blchinezu/bekant-mqtt32/images/hardware/requirements/100nf-ceramic-capacitor.jpg

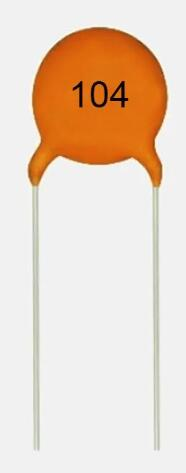
images/hardware/requirements/100nf-ceramic-capacitor.jpg
