blchinezu/bekant-mqtt32/images/hardware/requirements/box.jpg

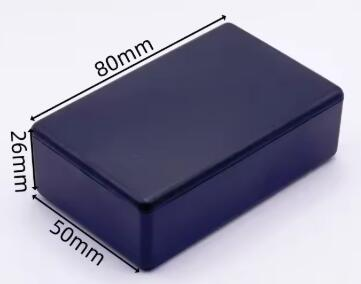
images/hardware/requirements/box.jpg
