blchinezu/bekant-mqtt32/images/hardware/requirements/buck-converter-5v.jpg

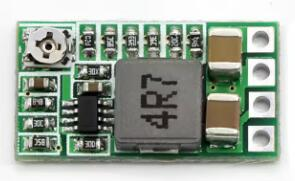
images/hardware/requirements/buck-converter-5v.jpg
