blchinezu/bekant-mqtt32/images/hardware/requirements/buck-converter-12v.jpg

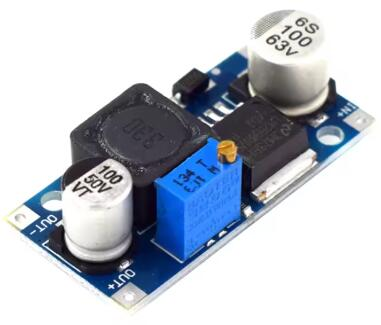
images/hardware/requirements/buck-converter-12v.jpg
