blchinezu/bekant-mqtt32/images/hardware/requirements/buttons.jpg

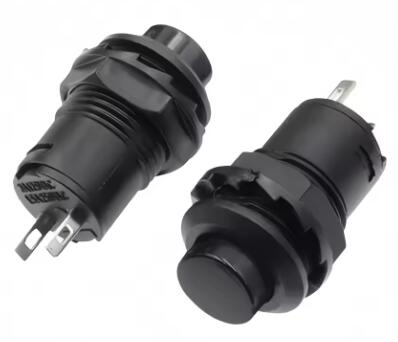
images/hardware/requirements/buttons.jpg
