blchinezu/bekant-mqtt32/images/hardware/requirements/esp32-d1-mini.jpg

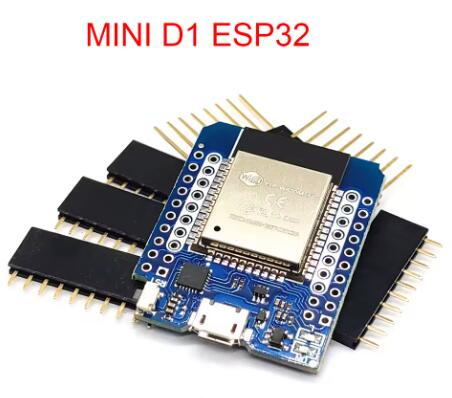
images/hardware/requirements/esp32-d1-mini.jpg
