blchinezu/bekant-mqtt32/images/hardware/requirements/mcp2003b.jpg

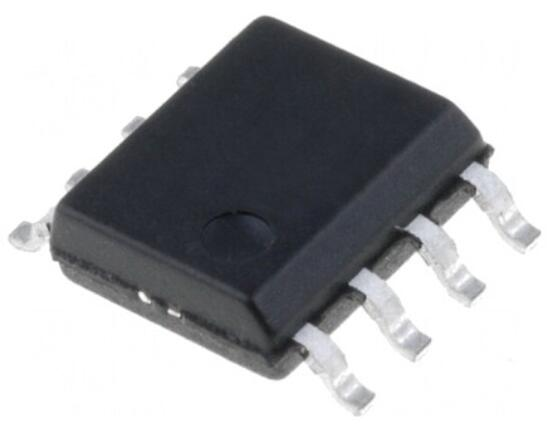
images/hardware/requirements/mcp2003b.jpg
