blchinezu/bekant-mqtt32/images/hardware/requirements/pcb.jpg

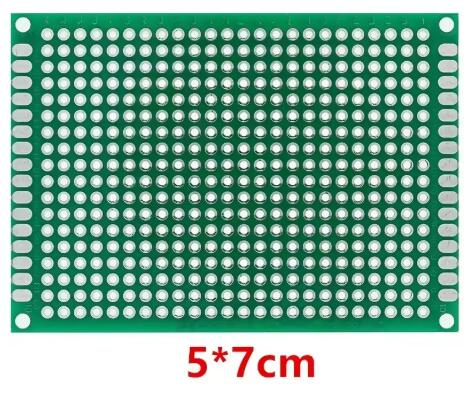
images/hardware/requirements/pcb.jpg
