blchinezu/bekant-mqtt32/images/hardware/requirements/sop8-to-dip8-pcb.jpg

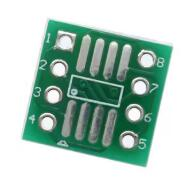
images/hardware/requirements/sop8-to-dip8-pcb.jpg
