blchinezu/bekant-mqtt32/lin.cpp

/*
 Copyright 2011 G. Andrew Stone
All rights reserved.

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
THIS SOFTWARE IS PROVIDED BY THE COPYRIGHT HOLDERS AND CONTRIBUTORS "AS IS" AND
ANY EXPRESS OR IMPLIED WARRANTIES, ZINCLUDING, BUT NOT LIMITED TO, THE IMPLIED
WARRANTIES OF MERCHANTABILITY AND FITNESS FOR A PARTICULAR PURPOSE ARE
DISCLAIMED. IN NO EVENT SHALL <COPYRIGHT HOLDER> BE LIABLE FOR ANY
DIRECT, INDIRECT, INCIDENTAL, SPECIAL, EXEMPLARY, OR CONSEQUENTIAL DAMAGES
(INCLUDING, BUT NOT LIMITED TO, PROCUREMENT OF SUBSTITUTE GOODS OR SERVICES;
LOSS OF USE, DATA, OR PROFITS; OR BUSINESS INTERRUPTION) HOWEVER CAUSED AND
ON ANY THEORY OF LIABILITY, WHETHER IN CONTRACT, STRICT LIABILITY, OR TORT
(INCLUDING NEGLIGENCE OR OTHERWISE) ARISING IN ANY WAY OUT OF THE USE OF THIS
SOFTWARE, EVEN IF ADVISED OF THE POSSIBILITY OF SUCH DAMAGE.
*/

#include "Arduino.h"
#include "lin.h"

Lin::Lin(LIN_SERIAL& ser,uint8_t TxPin,uint8_t RxPin)
  : serial(ser)
  , txPin(TxPin)
  , rxPin(RxPin)
{
}

void Lin::begin(int speed)
{
  serialSpd = speed;
  serial.begin(serialSpd, SERIAL_8N1, rxPin, txPin);
  serialOn  = 1;

  // More precise timing calculation like megadesk
  unsigned long int Tbit = 1000000UL/serialSpd;  // Convert to microseconds
  unsigned long int nominalFrameTime = (34+90)*Tbit;  // 34 bits header + 90 bits payload
  timeout = LIN_TIMEOUT_IN_FRAMES * nominalFrameTime;
}

// Generate a BREAK signal (a low signal for longer than a byte) across the serial line
void Lin::serialBreak(void)
{
  if (serialOn) {
    serial.flush();
    serial.end();
  }

  pinMode(txPin, OUTPUT);
  digitalWrite(txPin, LOW);  // Send BREAK
  const unsigned long int brkend = (1000000UL/((unsigned long int)serialSpd));
  const unsigned long int brkbegin = brkend*LIN_BREAK_DURATION;
  if (brkbegin > 16383) delay(brkbegin/1000);  // delayMicroseconds unreliable above 16383 see arduino man pages
  else delayMicroseconds(brkbegin);
  
  digitalWrite(txPin, HIGH);  // BREAK delimiter

  if (brkend > 16383) delay(brkend/1000);  // delayMicroseconds unreliable above 16383 see arduino man pages
  else delayMicroseconds(brkend);

  serial.begin(serialSpd, SERIAL_8N1, rxPin, txPin);
  serialOn = 1;
}

/* Lin defines its checksum as an inverted 8 bit sum with carry */
uint8_t Lin::dataChecksum(const uint8_t* message, char nBytes,uint16_t sum)
{
    while (nBytes-- > 0) sum += *(message++);
    // Add the carry
    while(sum>>8)  // In case adding the carry causes another carry
      sum = (sum&255)+(sum>>8); 
    return (~sum);
}

/* Create the Lin ID parity */
#define LIN_BIT(data,shift) ((addr&(1<<shift))>>shift)
uint8_t Lin::addrParity(uint8_t addr)
{
  uint8_t p0 = LIN_BIT(addr,0) ^ LIN_BIT(addr,1) ^ LIN_BIT(addr,2) ^ LIN_BIT(addr,4);
  uint8_t p1 = ~(LIN_BIT(addr,1) ^ LIN_BIT(addr,3) ^ LIN_BIT(addr,4) ^ LIN_BIT(addr,5));
  return (p0 | (p1<<1))<<6;
}

/* Send a message across the Lin bus */
void Lin::send(uint8_t addr, const uint8_t* message, uint8_t nBytes,uint8_t proto)
{
  uint8_t addrbyte = (addr&0x3f) | addrParity(addr);
  // LIN diagnostic (60) frame shall always use CHKSUM of protocol version 1.x (like megadesk)
  uint8_t cksum = dataChecksum(message,nBytes,(addr == 0x3c) ? 0: addrbyte);
  serialBreak();       // Generate the low signal that exceeds 1 char.
  serial.write(0x55);  // Sync byte
  serial.write(addrbyte);  // ID byte
  serial.write(message,nBytes);  // data bytes
  serial.write(cksum);  // checksum
  serial.flush();
}

uint8_t Lin::recv(uint8_t addr, uint8_t* message, uint8_t nBytes,uint8_t proto)
{
  uint8_t bytesRcvd=0;
  unsigned int timeoutCount=0;
  serialBreak();       // Generate the low signal that exceeds 1 char.
  serial.flush();
  
  // Debug: Check buffer state before starting
  int bufferBefore = serial.available();
  
  serial.write(0x55);  // Sync byte
  uint8_t idByte = (addr&0x3f) | addrParity(addr);
  serial.write(idByte);  // ID byte
  bytesRcvd = 0xfd;
  
  // Debug: Capture all bytes read for analysis
  uint8_t debugBytesRead[20];
  uint8_t debugByteCount = 0;
  int syncAttempts = 0;
  int idAttempts = 0;
  
  do { // I hear myself
    syncAttempts++;
    while(!serial.available()) { delayMicroseconds(100); timeoutCount+= 100; if (timeoutCount>=timeout) goto done; }
    uint8_t b = serial.read();
    if (debugByteCount < 20) debugBytesRead[debugByteCount++] = b;
    if (b == 0x55) break;
  } while(syncAttempts < 20);
  
  if (syncAttempts >= 20) goto done;
  
  bytesRcvd = 0xfe;
  do {
    idAttempts++;
    while(!serial.available()) { delayMicroseconds(100); timeoutCount+= 100; if (timeoutCount>=timeout) goto done; }
    uint8_t b = serial.read();
    if (debugByteCount < 20) debugBytesRead[debugByteCount++] = b;
    if (b == idByte) break;
  } while(idAttempts < 20);
  
  if (idAttempts >= 20) goto done;

  bytesRcvd = 0;
  for (uint8_t i=0;i<nBytes;i++)
  {
    // This while loop strategy does not take into account the added time for the logic.  So the actual timeout will be slightly longer then written here.
    while(!serial.available()) { delayMicroseconds(100); timeoutCount+= 100; if (timeoutCount>=timeout) goto done; } 
    message[i] = serial.read();
    if (debugByteCount < 20) debugBytesRead[debugByteCount++] = message[i];
    bytesRcvd++;
  }
  while(!serial.available()) { delayMicroseconds(100); timeoutCount+= 100; if (timeoutCount>=timeout) goto done; }
  if (serial.available())
  {
    uint8_t cksum = serial.read();
    if (debugByteCount < 20) debugBytesRead[debugByteCount++] = cksum;
    bytesRcvd++;
    // LIN diagnostic (61) frame shall always use CHKSUM of protocol version 1.x (like megadesk)
    if (dataChecksum(message,nBytes,(addr == 0x3d) ? 0: idByte) != cksum) bytesRcvd = 0xff;
  }

done:
  serial.flush();
  
  // Store debug data for external access
  lastRecvAddr = addr;
  lastRecvResult = bytesRcvd;
  lastRecvTimeout = timeoutCount;
  lastRecvBufferBefore = bufferBefore;
  lastRecvDebugByteCount = debugByteCount;
  for (uint8_t i = 0; i < debugByteCount && i < 20; i++) {
    lastRecvDebugBytes[i] = debugBytesRead[i];
  }
  lastRecvSyncAttempts = syncAttempts;
  lastRecvIdAttempts = idAttempts;

  return bytesRcvd;
}
