blchinezu/bekant-mqtt32/(commit log)

2025-12-16 Added schematic
2025-12-16 Switched all images from png to jpg
